MSzmaj/ComputerEngineeringCapstone/Other/Drivers/Arduino Nano/readme.txt

Driver taken from: https://github.com/adrianmihalko/ch340g-ch34g-ch34x-mac-os-x-driver
All credit to user adrianmihalko
