MSzmaj/ComputerEngineeringCapstone/Documentation/Reports/Capstone Functional Decomposition.pdf

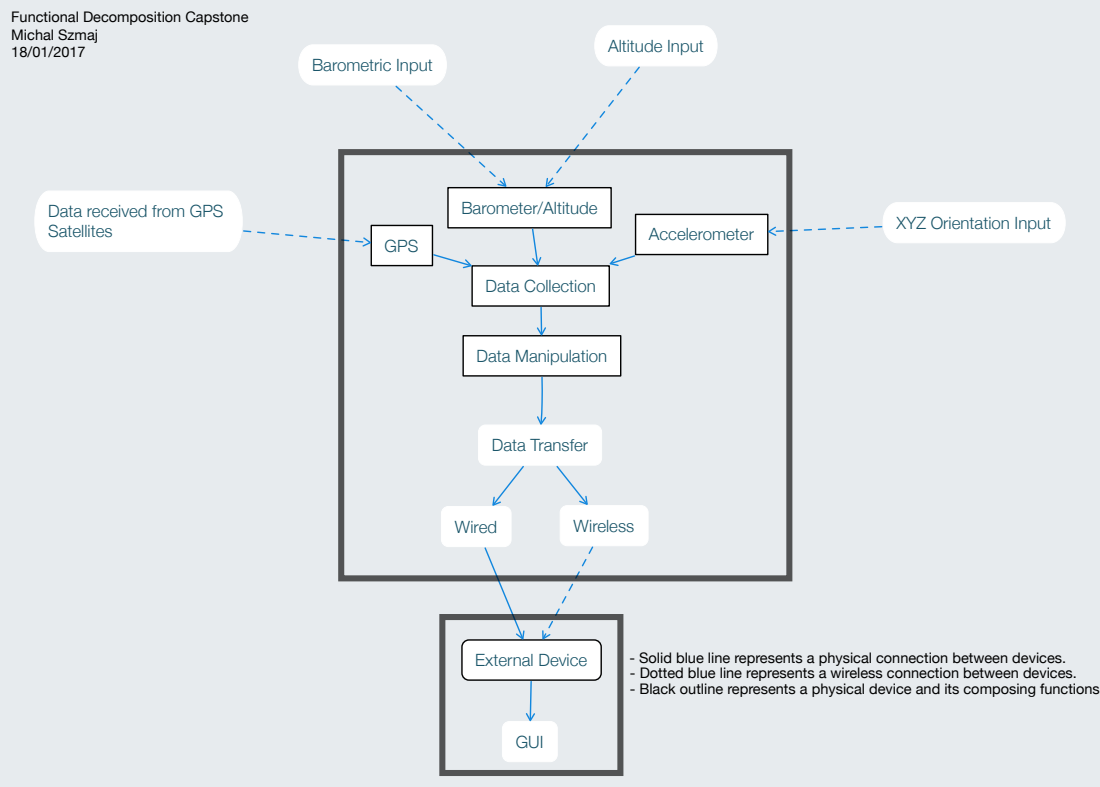
[picture p36: page 1]
Altitude Input; Barometric Input; Data received from GPS; Barometer/Altitude; Satellites; XYZ Orientation Input Accelerometer GPS; Data Collection; Data Manipulation; Data Transfer; Wired; Wireless; External Device; GUI
