MSzmaj/ComputerEngineeringCapstone/(list of files, drawings)

Other design files:
Documentation/Schematics/BlackBox.fzz
