MSzmaj/ComputerEngineeringCapstone/Code/Arduino/Main/Main/DataConversionLibrary.hpp

#ifndef DataConversionLibrary_hpp
#define DataConversionLibrary_hpp

#include <stdio.h>
#include <WString.h>

#endif /* DataConversionLibrary_hpp */

//Converts a given string to a char arrray.
char* convertStringToCharArray (String string);
