MSzmaj/ComputerEngineeringCapstone/Code/Arduino/Testing/BMP180NEW/BMP180/BMP180LibraryDebugging.hpp

#ifndef BMP180LibraryDebugging_hpp
#define BMP180LibraryDebugging_hpp

#include <stdio.h>

#endif /* BMP180LibraryDebugging_hpp */

void debugCalibration (void);
void debugReadings (long UT, long UP, float T, float P);
